ArduinoTM/stm32_aimereader/(commit log)

2022-12-05 update 一部分 count 1
2022-12-05 上传程序
2022-12-05 +程序使用说明
2022-12-06 测试图片是否正常加载
2022-12-06 V1 原理图公示
2022-12-06 v1A原理图
2022-12-06 串口原理
2022-12-06 串口原理相关图片
2022-12-19 v1.0b程序发布，支持屏幕，支持电脑上位机改参数！
2022-12-19 Create 这是旧版程序，没有屏幕什么的，不建议使用
2022-12-19 v1.0b bootloader，scl-vcc上电进bl，或者串口进
    来自github开源项目的修改
2022-12-19 pcb和电路暂时有bug，马上修，很好修，现在先不要用，别急！
2022-12-19 1.0b设备配置器，没写完！！！！
2023-01-02 加1.0b图
2023-01-22 重磅更新1
2023-01-22 SpiceAPI程序！！！！！！！
2023-01-22 SpiceAPI使用教程
2023-01-22 修复串口后SBGA版本开源stm32-aimereader.zip
2023-01-22 v1r pcb 最新 重磅 稳定！
2023-01-23 SpiceAPI源码
2023-01-23 修复重磅更新1
2023-01-24 重磅更新，现在我们有三模
2023-01-24 添加Banapass相关源码重磅更新
2023-01-24 重磅更新三模三社
2023-01-24 修改后的TAL源码
2023-02-07 清理垃圾，更新写卡
2023-02-07 1.0rhW带写卡和重置的源码包
    1.0rhW带写卡和重置的源码包
